kabadisha/aquarium-controller/(list of files, drawings)

Other design files:
EasyEDA-Schematic.json
