kabadisha/aquarium-controller/(commit log)

2016-07-23 Zipped library to prevent conflicts. The arduino IDE handles libraries very badly.
    [aquarium-controller.ino]
2016-07-23 Added interrupt to update the date & time on the display every second.
2016-07-23 Added some comments to link to reference material for libraries.
2016-07-23 Removed need for interrupts as this was causing a glitchy display. Other organisational tweaks.
    [aquarium-controller.ino]
2016-08-07 Added schematic
2016-08-07 Changed schematic image in readme to an svg
2016-08-08 Fixed small wiring issue in schematic
2016-08-08 Added link to original schematic online editor
2016-08-29 Fixed indentation. No functional change.
    [aquarium-controller.ino]
2016-10-30 Update schematic. Supply solenoid with 12V. Proper values for resistors for more reliability.
2017-01-08 Add code to set time via serial Refactored pins to allow for changed board layout that adds plugs & sockets for the display. Added a CO2 override switch to manually turn on CO2
2017-02-05 Optimised code during debugging session. Turned out that the root issue was a tiny accidental solder bridge between pins D11 and D12. FFS!
    [aquarium-controller.ino]
2017-02-06 Add EasyEDA schematic source for safe keeping
    [EasyEDA-Schematic.json]
2017-02-12 Add relay to control mains air pump.
    [EasyEDA-Schematic.json]
2017-02-12 BUGFIX: Air on at night, so logic reversed. Need a better way of representing time windows...
    [aquarium-controller.ino]
2017-03-27 Add separate air on time. Set air to come on for two hours per day to prevent surface scum.
    [aquarium-controller.ino]
2017-05-07 Update to use alarms for triggering lights, co2 and air. Setting the time via serial will now result in boot-up without the need to reset.
    [aquarium-controller.ino]
2017-05-09 Refactoring and bug fixes. Known Bug: Currently arduino must be reset after setting new time over serial or alarms are not triggered.
    [aquarium-controller.ino]
2017-05-09 Fix issue where alarms are disabled after setting time via serial.
    [aquarium-controller.ino]
2017-05-10 Fixed bug with function to check if x millis have passed The function was using only one shared last millis state, so only the check providing the lowest interval won. Refactored so that each invocat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
    [aquarium-controller.ino]
2017-05-10 Fix delay check function. Needed to use a pointer for the since variable.
    [aquarium-controller.ino]
2017-05-15 Simply re-enable alarms, don’t just recreate them.
2017-05-17 Update schematic. Add power indicator LED Minor reorganisation
    [EasyEDA-Schematic.json]
2017-06-18 Remove delay to find out if that solves the alarms being missed.
    [aquarium-controller.ino]
2017-06-20 Trying to make alarms trigger reliably by making sure clock sync avoids alarm times.
    [aquarium-controller.ino]
